petl/heatgun/schematics/readme

Schematics are drawn in eagle. Some parts are misused and if you build this yourself it's at your own risk!
