petl/heatgun/photos/IMG_20160820_193004.jpg

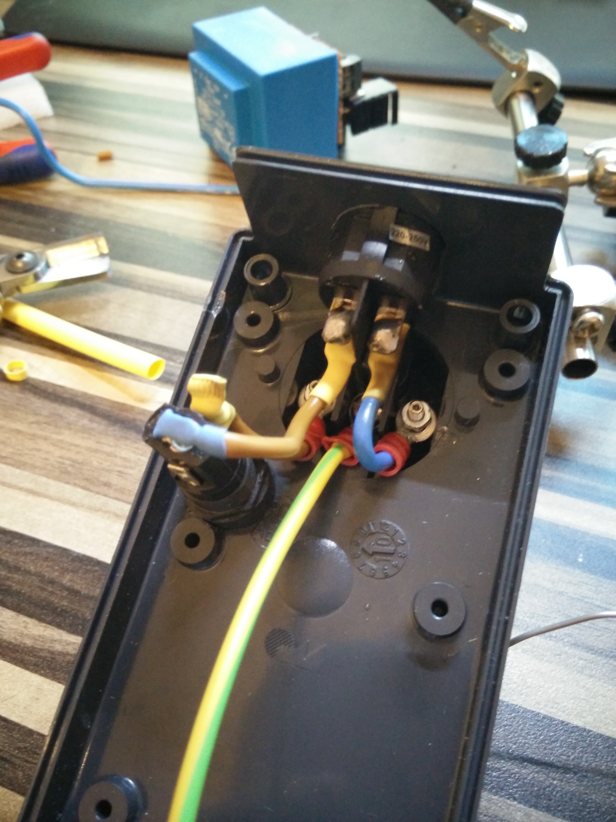
photos/IMG_20160820_193004.jpg
