petl/heatgun/photos/IMG_20160820_201428.jpg

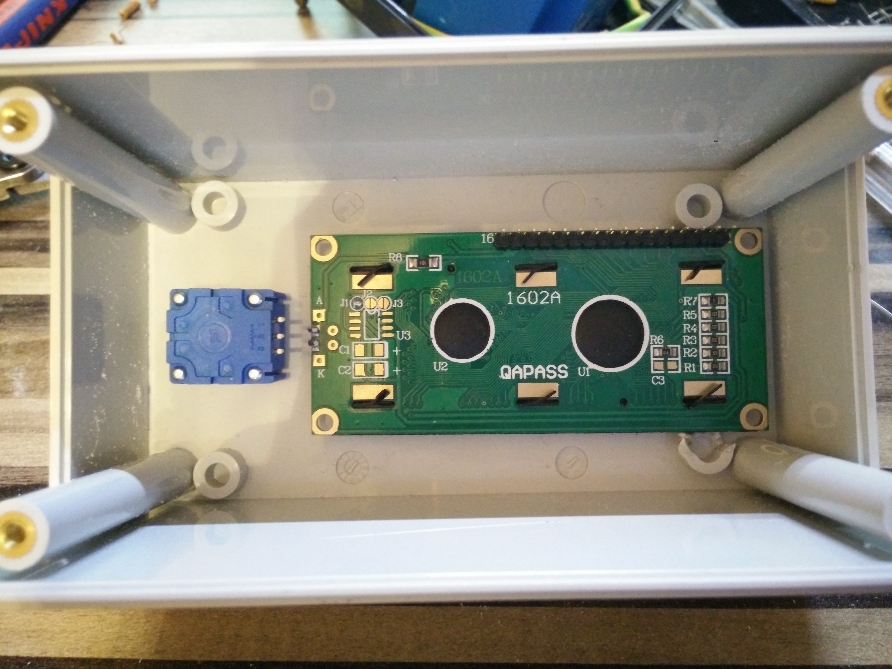
photos/IMG_20160820_201428.jpg
