petl/heatgun/photos/IMG_20160820_235933.jpg

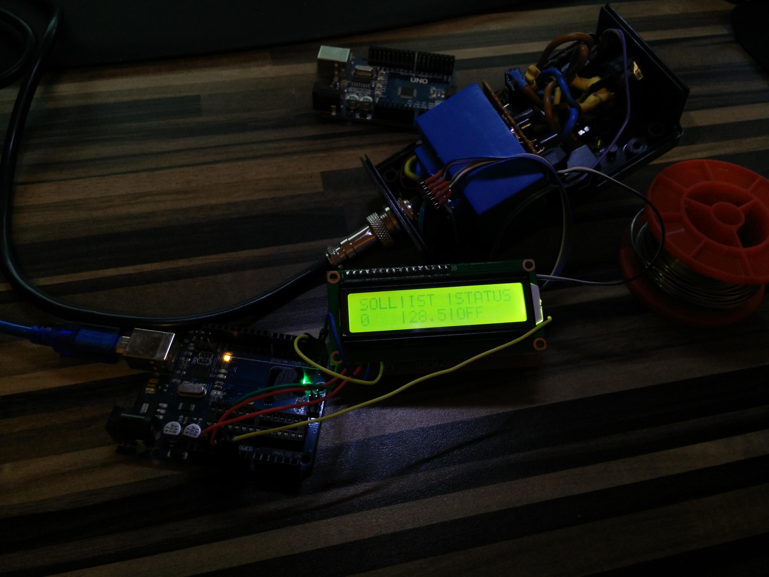
photos/IMG_20160820_235933.jpg
