petl/heatgun/photos/IMG_20160821_003230.jpg

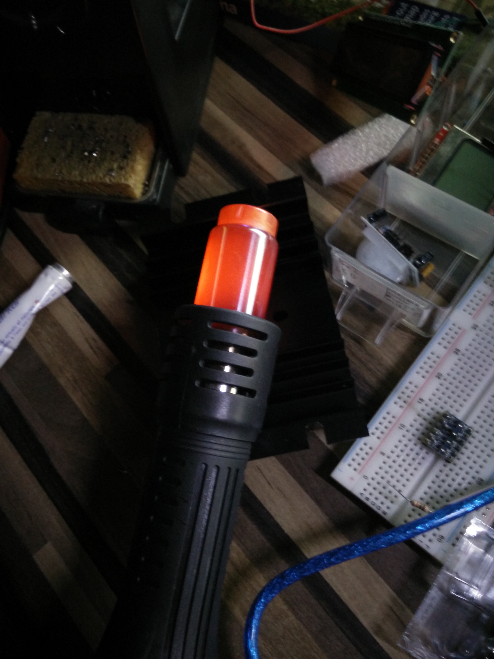
photos/IMG_20160821_003230.jpg
