petl/heatgun/photos/IMG_20160821_004454.jpg

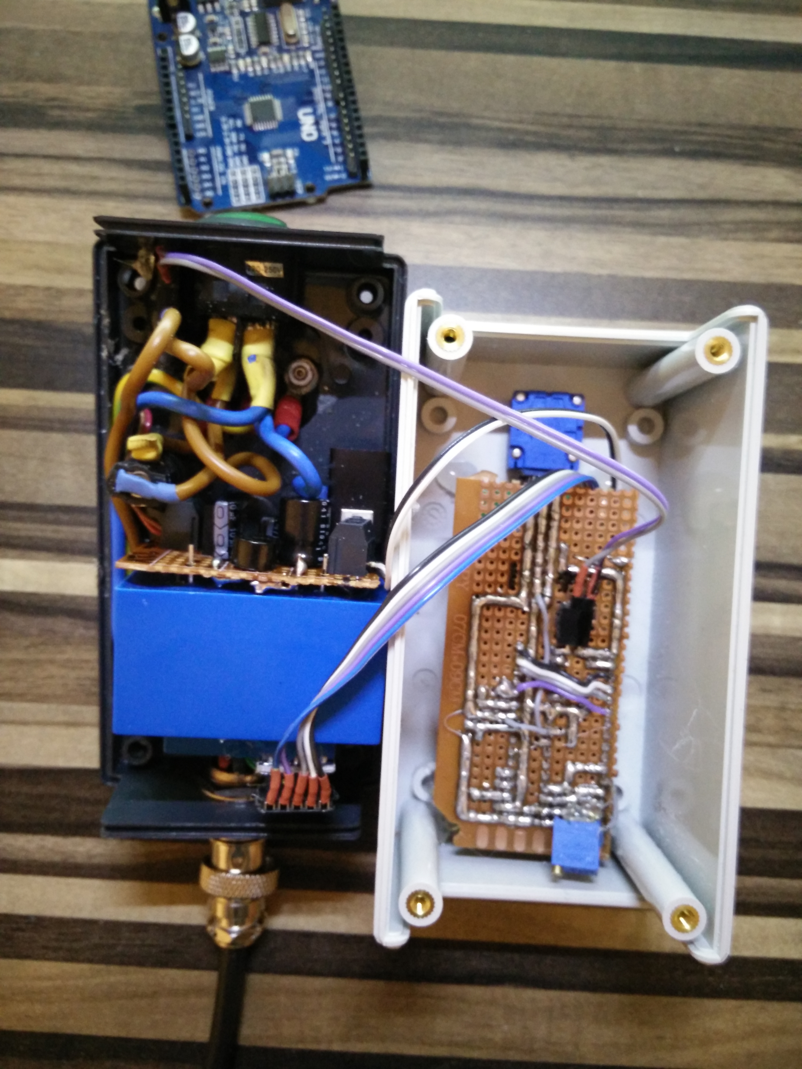
photos/IMG_20160821_004454.jpg
