petl/heatgun/photos/IMG_20160821_010603.jpg

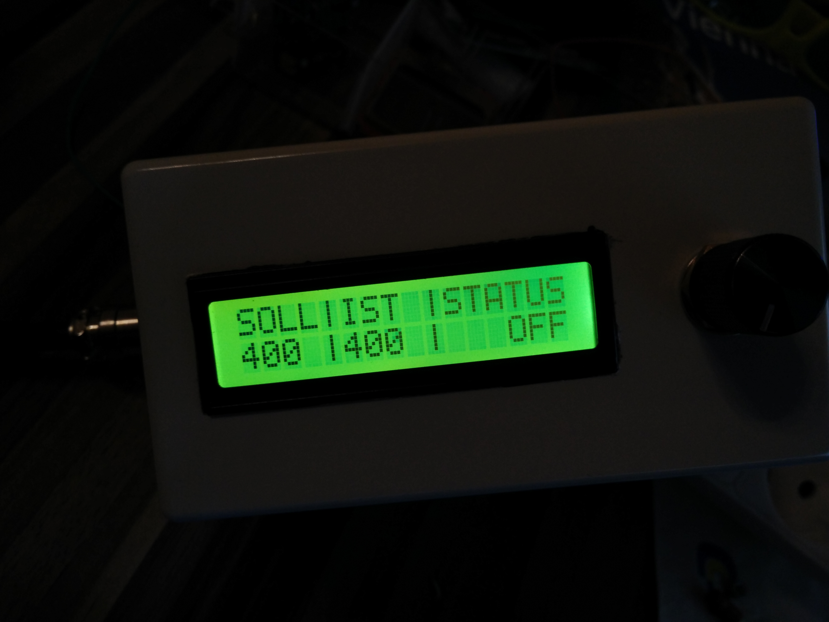
photos/IMG_20160821_010603.jpg
