petl/heatgun/BOM.ods

Bill of materials
 | readable name | Name | Supplier link | Part.No. | Price/€ | Amount
 | Case | Schutzkontakt Steckergehäuse DE, ABS grau, 120 x 65 x 65mm | http://uk.rs-online.com/web/p/netzteilgehause/0583426/ | A9021665 | 24.876 | 1
 | Heatgun | Heißluftpistole Heißluftgerät Heißluftfön Handgerät Zubehör 60Ohm | http://www.ebay.com/itm/401129852165 | 858D | 13.15 | 1
 | Fuse holder | Bulgin FX0462 5 x 20mm Sicherungshalter für die Tafelmontage, bis 10A, | http://uk.rs-online.com/web/p/sicherungshalter-fuer-frontplattenmontage/5125996/ | FX0462 | 4.3152 | 1
 | Fuse | Cooper Bussmann Feinsicherung, T / 4A, Ø 5mm | http://uk.rs-online.com/web/p/feinsicherungen/5371105/ | S505-4-R | 0.6912 | 1
 | Transformer | EI 48/16,8 Printtransformator VC 10 VA Primär: 230 V Sekundär: 12 V 833 mA | https://www.conrad.at/de/ei-48168-printtransformator-vc-10-va-primaer-230-v-sekundaer-12-v-833-ma-10-va-vc-10112-block-710458.html | VC 10/1/12 | 8.79 | 1
 | DCDC-converter | Print TracoPower TSR 1-24120 24 V/DC 12 V/DC 1 A | https://www.conrad.at/de/dcdc-wandler-print-tracopower-tsr-1-24120-24-vdc-12-vdc-1-a-6-w-anzahl-ausgaenge-1-x-156677.html | TSR 1-24120 | 7.09 | 1
 | SSR | Lastrelais 1 St. Sharp S 202 T02 Last-Strom 2 A Schaltspannung 250 V/AC | https://www.conrad.at/de/elektronische-lastrelais-1-st-sharp-s-202-t02-last-strom-2-a-schaltspannung-250-vac-162574.html | S 202 T02 | 5.49 | 1
 | Rectifier | Silizium-Brückengleichrichter 2 A Diotec B40R Nennstrom 2 A U(RRM) 80 V | https://www.conrad.at/de/silizium-brueckengleichrichter-2-a-diotec-b40r-nennstrom-2-a-u-rrm-80-v-501433.html | B40R | 0.24 | 1
 | Switch | Wippschalter 250 V/AC 10 A 2 x Aus/Ein SCI R13-244B-02 B/G 220 V/AC | https://www.conrad.at/de/wippschalter-250-vac-10-a-2-x-ausein-sci-r13-244b-02-bg-220-vac-rastend-1-st-701003.html | R13-244B-02 B/G 220 V/AC | 2.99 | 1
 | Screw terminal | Schraubklemmblock 1.50 mm² Polzahl 2 AK500/2DS-5.0-V PTR Grau 1 St. | https://www.conrad.at/de/schraubklemmblock-150-mm-polzahl-2-ak5002ds-50-v-ptr-grau-1-st-729949.html | 50500020121G | 0.28 | 1
 | Connector | Miniatur-DIN-Rundsteckverbinder Stecker, Einbau vertikal Polzahl: 8 Silber | https://www.conrad.at/de/miniatur-din-rundsteckverbinder-stecker-einbau-vertikal-polzahl-8-silber-cliff-fc684208-1-st-736652.html | FC684208 | 3.99 | 1
 | Capacitor | 330µF |  |  |  | 1
 | Capacitor | 1µ |  |  |  | 2
 | Capacitor | 4µ7 |  |  |  | 1
 | Regulator | 7805 |  |  |  | 1
 | LCD | LCD Monochrom-Display, alphanumerisch, 2-zeilig, 16 Zeichen | http://at.rs-online.com/web/p/lcd-displays-monochrom/5326486/ | 162D-BC-BC | 8.892 | 1
 | Potentiometer | Bourns Serie 91 Cermet-Potenziometer, 5kΩ lin ±20% 2W, Schaft-Ø 6 mm | http://at.rs-online.com/web/p/potenziometer/8274969/ | 91R1A-R22-B13L | 5.772 | 1
 | Potentiometer knob | RS Pro Potentiometer Knob, Body: Black, Dia. 20Mm 6mm Shaft | http://at.rs-online.com/web/p/potenziometer-knopfe/7777319/ | 777-7319 | 2.028 | 1
 | LCD potentiometer | Bourns 3296W 25-Gang Printmontage Cermet Trimm-Potenziometer, 10kΩ | http://at.rs-online.com/web/p/abgleichwiderstande/5219647/ | 3296W-1-103LF | 2.532 | 1
 | Microcontroller | ATMEGA328-PU, AVR 8 bit 1 kB, 2 kB RAM, 32 KB Flash, PDIP 28-Pin | http://at.rs-online.com/web/p/mikrocontroller/7380435/ | ATMEGA328-PU | 3.516 | 1
 | Crystal | Quarz FOXSLF/160-20 16MHz, ±30ppm, HC-49-SLF 2-Pin | http://at.rs-online.com/web/p/quarzmodule/5476294/ | FOXSLF/160-20 | 0.5136 | 1
 | Crystal Cap | Kemet C Vielschicht Keramikkondensator C0G, 22pF ±5% / 200 V | http://at.rs-online.com/web/p/keramik-multilayer-kondensatoren/5381219/ | C315C220J2G5TA | 0.382 | 2
 | Decoupling Cap | Kemet C Vielschicht Keramikkondensator X7R, 100nF ±10% / 50 V | http://at.rs-online.com/web/p/keramik-multilayer-kondensatoren/5381310/ | C320C104K5R5TA | 0.134 | 1
 | Reset pullup | 10k Ohm |  |  |  | 1
 | Sensor module | Details zu MAX6675 K Type SPI Thermocouple Temperature Sensor Module | http://www.ebay.at/itm/181948586145 | MAX6675K | 6.34 | 1
 | Proto board | Lochraster Experimentierplatine, 101.6mm x 122mm | http://at.rs-online.com/web/p/lochrasterplatinen/1004081/ | 01-0021 | 8.484 | 1
 | Cables |  |  |  |  | 1
 | Onboard connectors |  |  |  |  | 1
 |  |  |  |  | 110.496
