petl/heatgun/schematics/heatgun.sch

## EAGLE design schematics/heatgun.sch (2016-08-21)

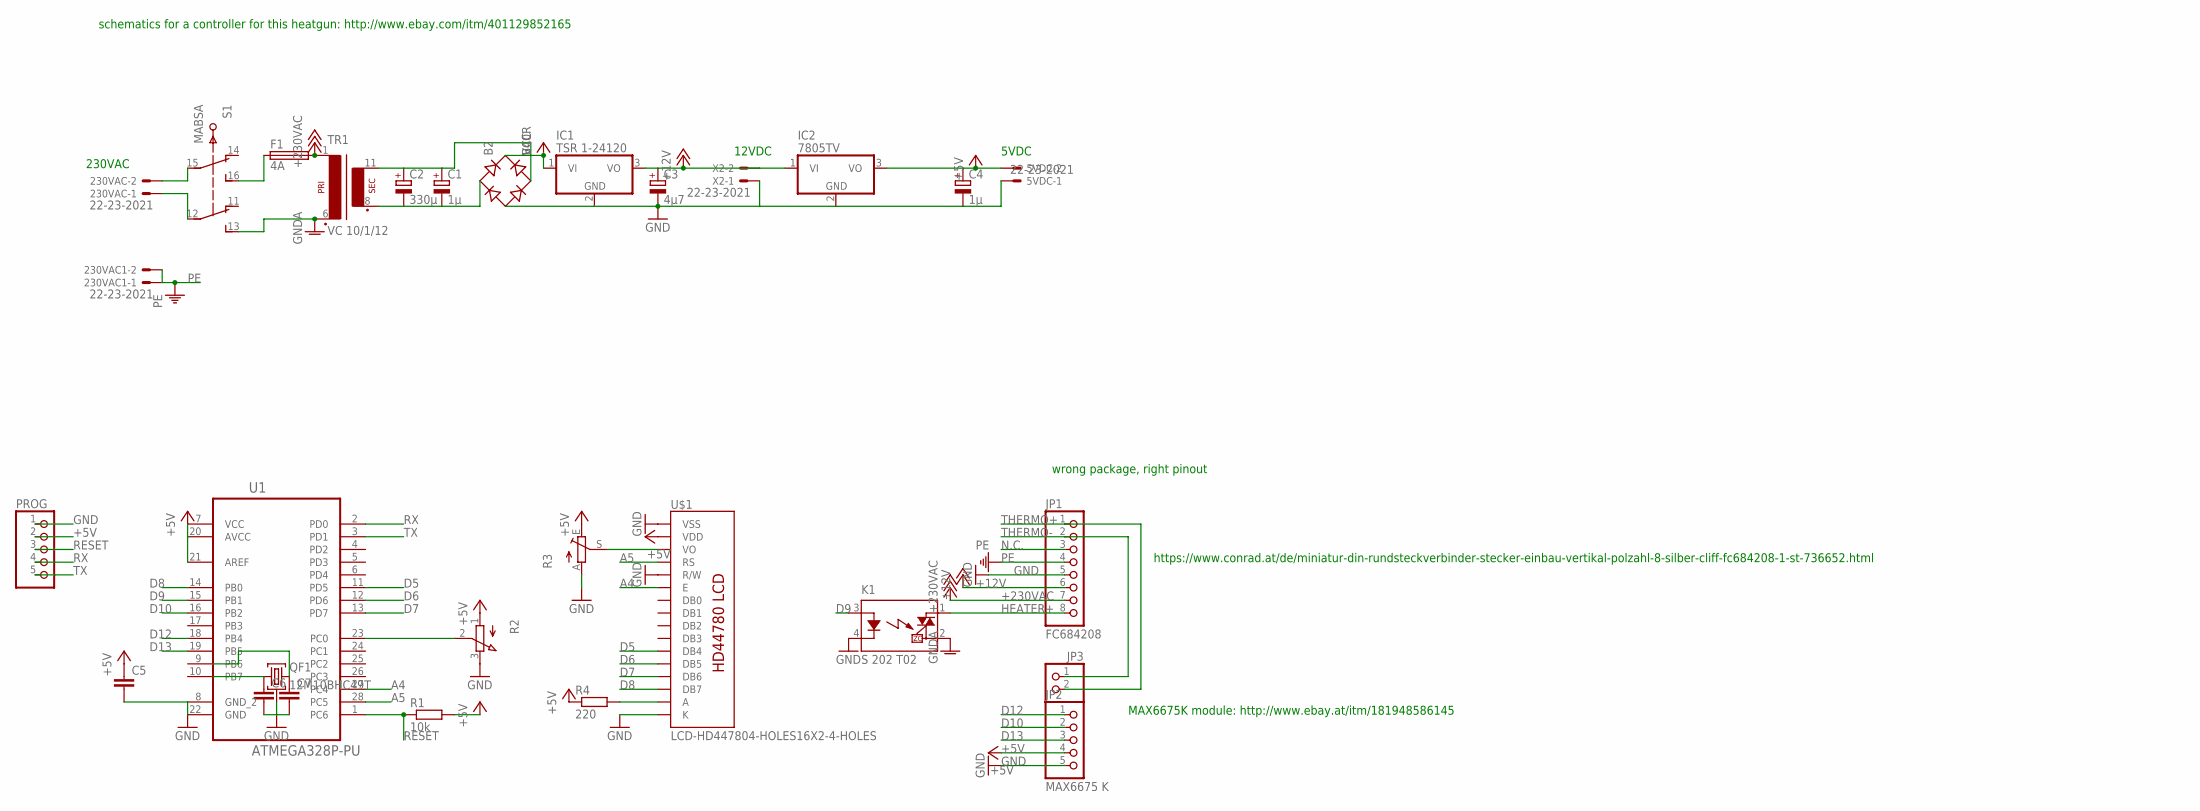
[picture p9: schematic heatgun.sch]

Parts:
5VDC, 230VAC, 230VAC1: 22-23-2021
B2: B40R; RB1A
C1: 1µ; EB25D
C2: 330µ; E2-4
C3: 4µ7; E2-4
C4: 1µ; E2-4
C5: C-EU025-025X050; C025-025X050
C6, C7: C-EU025-024X044; C025-024X044
F1: 4A; SHK20L
IC1: TSR 1-24120; TO220V
IC2: 7805TV; TO220V
JP1: FC684208; 1X08
JP2: MAX6675 K; 1X05
JP3: PINHD-1X2; 1X02
K1: S 202 T02; S202S02
PROG: PINHD-1X5; 1X05
QF1: 12M10BHC49T; HC49U
R1: 10k; 0207/2V
R2: 3RP/1610N
R3: TRIM_EU-B64Y; B64Y
R4: 220; 0207/2V
S1: MABSA
TR1: VC 10/1/12; EI48-1
U1: ATMEGA328P-PU; DIP254P762X457-28
U$1: LCD-HD447804-HOLES16X2-4-HOLES; LCD-16X2-4HOLES
X2: 22-23-2021

Connections:
+5V: 5VDC.2, C4.+, C5.1, IC2.3 (VO), JP2.4, PROG.2, R1.2, R2.1 (A), R3.E, R4.1, U1.7 (VCC), U1.20 (AVCC), U1.21 (AREF), U$1.2 (VDD)
+12V: C3.+, IC1.3 (VO), IC2.1 (VI), JP1.6, X2.2
+230VAC: F1.2A, JP1.7, TR1.1
A4: U1.27 (PC4), U$1.6 (E)
A5: U1.28 (PC5), U$1.4 (RS)
D5: U1.11 (PD5), U$1.11 (DB4)
D6: U1.12 (PD6), U$1.12 (DB5)
D7: U1.13 (PD7), U$1.13 (DB6)
D8: U1.14 (PB0), U$1.14 (DB7)
D9: K1.3 (A), U1.15 (PB1)
D10: JP2.2, U1.16 (PB2)
D12: JP2.1, U1.18 (PB4)
D13: JP2.3, U1.19 (PB5)
GND: 5VDC.1, B2.-, C3.-, C4.-, C5.2, C6.2, C7.2, IC1.2 (GND), IC2.2 (GND), JP1.5, JP2.5, K1.4 (K), PROG.1, QF1.2, R2.3 (E), R3.A, U1.8 (GND_2), U1.22 (GND), U$1.1 (VSS), U$1.5 (R/W), U$1.16 (K), X2.1
GNDA: K1.2 (DS2), S1.13, TR1.6 (P2)
HEATER+: JP1.8, K1.1 (DS1)
unnamed: 230VAC.2, S1.15
unnamed: 230VAC.1, S1.12
unnamed: B2.AC1, C1.-, C2.-, TR1.8 (S3)
unnamed: B2.AC2, C1.+, C2.+, TR1.11 (S4)
unnamed: R2.2 (S), U1.23 (PC0)
unnamed: R3.S, U$1.3 (VO)
unnamed: C6.1, QF1.1
unnamed: C7.1, QF1.3
unnamed: R4.2, U$1.15 (A)
unnamed: F1.1A, S1.16
N.C.: JP1.3
PE: 230VAC1.1, 230VAC1.2, JP1.4
RESET: PROG.3, R1.1, U1.1 (PC6)
RX: PROG.4, U1.2 (PD0)
THERMO+: JP1.1, JP3.2
THERMO-: JP1.2, JP3.1
TX: PROG.5, U1.3 (PD1)
VCC: B2.+, IC1.1 (VI)

Notes on the sheet:
230VAC
12VDC
5VDC
wrong package, right pinout
schematics for a controller for this heatgun: http://www.ebay.com/itm/401129852165
MAX6675K module: http://www.ebay.at/itm/181948586145
https://www.conrad.at/de/miniatur-din-rundsteckverbinder-stecker-einbau-vertikal-polzahl-8-silber-cliff-fc684208-1-st-736652.html
