petl/heatgun/original-manual.pdf

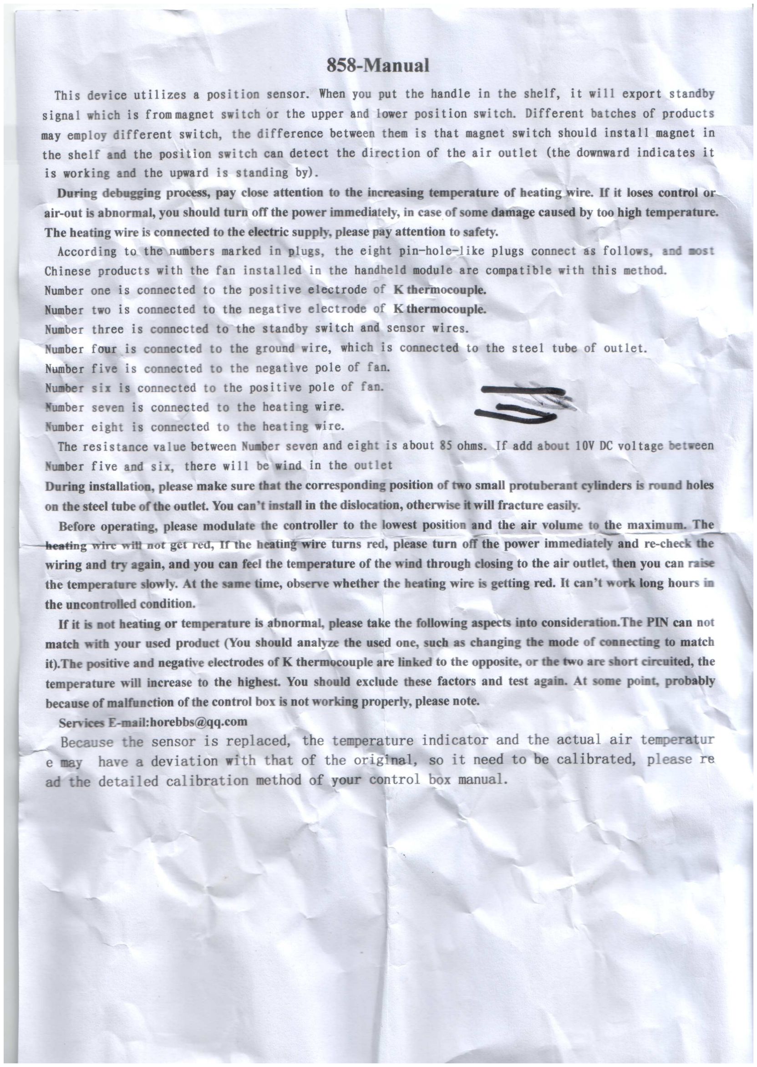
[picture p10: page 1]
