petl/heatgun/(commit log)

2016-08-21 added the schematics
    [heatgun.sch]
2016-08-21 The manual that came with the heatgun
    Pinout and general description of the heatgun.
2016-08-21 added BOM
